nickpei/AMDRONE/Resources.docx

Resources for MeArm:

Hack the Brain board

https://shop.mime.co.uk/blogs/news/68196933-hacking-the-mearm-brains-board

Run with Raspberry pi

https://shop.mime.co.uk/blogs/news/74739717-mearm-on-the-raspberry-pi-work-in-progress

Camera on Raspberry Pi

https://www.raspberrypi.org/learning/getting-started-with-picamera/worksheet/

Arduino Servo motor instructions

http://www.instructables.com/id/Arduino-Servo-Motors/

Using xbox 360 wireless control arm

https://www.intorobotics.com/arduino-robotic-arm-controlled-xbox-360-wireless-controller/
