nickpei/AMDRONE/Robotic arm Python/pythonServoControl/pythonServoControl.ino

// Import the Arduino Servo library
#include<Servo.h>

// Create a Servo object for each servo
Servo Base;//Servo 1, 80~110 right~left
Servo Left;//Servo 2,
Servo Right;//Servo 3,
Servo Claw;//Servo 4, 25~90 release~grab

// Common servo setup values
int minPulse = 600;   // minimum servo position, us (microseconds)
int maxPulse = 2400;  // maximum servo position, 

// User input for servo and position
int userInput[3];    // raw input from serial buffer, 3 bytes
int startbyte;       // start byte, begin reading input
int servo;           // which servo to pulse?
int pos;             // servo angle 0-180
int i;               // iterator

void setup() {
  // Attach each Servo object to a digital pin
  Base.attach(6, minPulse, maxPulse);
  Left.attach(9, minPulse, maxPulse);
  Right.attach(5, minPulse, maxPulse);
  Claw.attach(3, minPulse, maxPulse);

  // Open the serial connection, 9600 baud
  Serial.begin(9600);
}

void loop() {

  // Wait for serial input (min 3 bytes in buffer)
  if (Serial.available() > 2) {
    // Read the first byte
    startbyte = Serial.read();
    // If it's really the startbyte (255) ...
    if (startbyte == 255) {
      // ... then get the next two bytes
      for (i=0;i<2;i++) {
        userInput[i] = Serial.read();
      }
      // First byte = servo to move?
      servo = userInput[0];
      // Second byte = which position?
      pos = userInput[1];
      // Packet error checking and recovery
      if (pos == 255) { servo = 255; }

      // Assign new position to appropriate servo
      switch (servo) {
        case 1:
          Base.write(pos);    // move servo1 to 'pos'
          break;
        case 2:
          Left.write(pos);
          break;
        case 3:
          Right.write(pos);
          break;
        case 4:
          Claw.write(pos);
          break;

      }
    }
  }
  
}
